LittleMooMooDingDingCow/3D-Printed-17-1-Cycloidal-Robotic-Actuator/Pictures&Videos/Screenshot 2026-03-27 005910.png

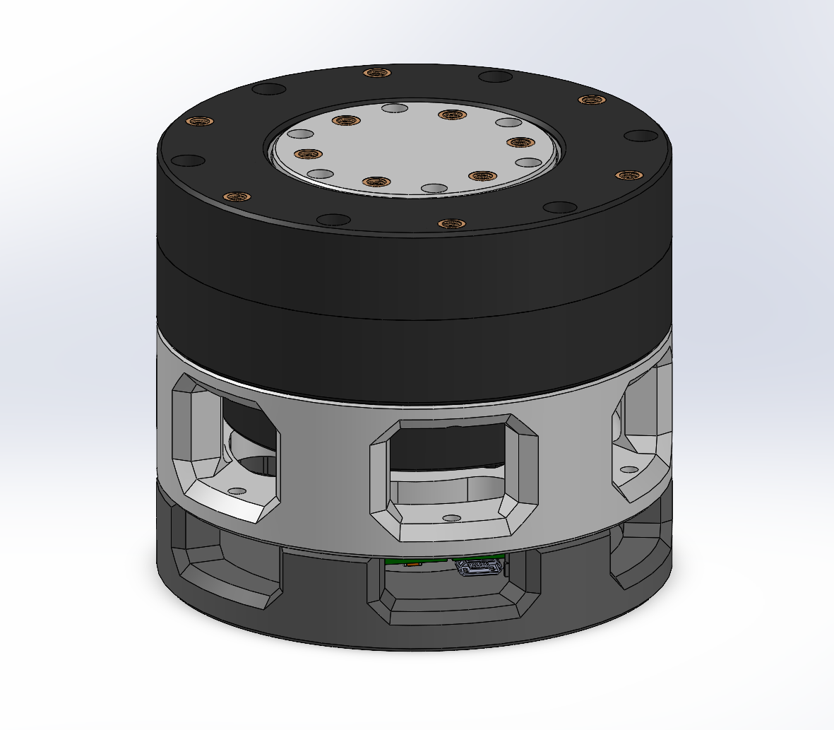
Pictures&Videos/Screenshot 2026-03-27 005910.png
