LittleMooMooDingDingCow/3D-Printed-17-1-Cycloidal-Robotic-Actuator/Cycloidal Actuator BOM/Cycloidal 25 to 1 BOM.xlsx

ITEM NO. | PART NUMBER | DESCRIPTION | Web Link for Purchasing | Cost per Time Purchased($) | Quantity Per Time Purchased (pcs & kg) | Part Unit Cost Per Purcahse($) | QTY. | Cost per Assembly
1 | Ring Gear | 3D printed PLA | https://a.co/d/0gjZemYR | 29.98 | 0.0301 | 0.451 | 1 | 0.451199
2 | Opposite Ring Gear |  |  |  | 0.0301 | 0.451 | 1 | 0.451199
3 | Cycloidal Gear |  |  |  | 0.0115 | 0.172 | 2 | 0.3444702
4 | Input Shaft |  |  |  | 0.0036 | 0.054 | 1 | 0.0535143
6 | Spacer Washer |  |  |  | 0.0002 | 0.002 | 1 | 0.0023984
11 | Bearing Spacer Big |  |  |  | 0.0004 | 0.006 | 1 | 0.0055463
13 | HM155kV Motor Mount V2 |  |  |  | 0.0422 | 0.633 | 1 | 0.6327279
14 | Encoder Magnent Mount |  |  |  | 0.0005 | 0.007 | 1 | 0.0068954
16 | Shaft Coupler for HM155KV |  |  |  | 0.0032 | 0.049 | 1 | 0.0485676
18 | FOC Board Spacer |  |  |  | 0.0001 | 0.002 | 4 | 0.0077948
23 | V3 Output Shaft Opposite |  |  |  | 0.0125 | 0.188 | 1 | 0.1876748
20 | V2 Output Shaft |  |  |  | 0.0195 | 0.293 | 1 | 0.2926048
7 | 50mm*65mm*7mm Ball Bearing | Bearing For both Ring Gears | https://a.co/d/0iJVO1oG | 28.09 | 10.0 | 2.809 | 2 | 5.618
8 | M3*0.5 BY 25mm Socket Head Screw | Screw to secure two Ring Gears together | https://www.aliexpress.us/item/2251832255868282.html | 2.65 | 50.0 | 0.053 | 6 | 0.318
9 | 15mm by 24mm by 5mm Ball Bearing | Beaing for Cycloidal Gear | https://www.aliexpress.us/item/3256805951929226.html | 7.78 | 10.0 | 0.778 | 2 | 1.556
10 | M3 by 8mm Button Head Cap Screw | Screw for both Motor Mount and Motor Coupler connection | https://www.aliexpress.us/item/3256807424674896.html | 3.29 | 50.0 | 0.066 | 10 | 0.658
12 | M4 by 8mm Button Head Cap Screw | Screw to secure the HM155kv onto Motor Mount | https://www.aliexpress.us/item/3256807424674896.html | 3.29 | 20.0 | 0.165 | 4 | 0.658
15 | M3 by 2.4mm Hex Nut | Nut to secure the FOC Board | https://www.aliexpress.us/item/3256807507915715.html | 1.71 | 50.0 | 0.034 | 4 | 0.1368
17 | HM-6208 motor | Electric Motor | https://www.hobbywingdirect.com/products/xrotor-m-6208-motor-ul | 60 | 1.0 | 60.000 | 1 | 60
19 | 22mm*10mm*6mm Ball Bearing | Bearing to secure the Input Shaft | https://a.co/d/02soELBD | 8.29 | 8.0 | 1.036 | 1 | 1.03625
21 | M2.5 by 25mm Socket Head Screw | Screw to secure and strengthen the Ouput Shaft | https://www.aliexpress.us/item/2251832255868282.html | 2.1 | 50.0 | 0.042 | 6 | 0.252
22 | 6mm*8mm*12mm Sleeve Bearing | Bearing to be used at the contact of Cycloidal Gear and the Output Shaft | https://a.co/d/09450dIv | 6.09 | 8.0 | 0.761 | 6 | 4.5675
24 | 25mm*37mm*7mm Bearing | Bearing to secure the Motor Coupler and the Input Shaft on the Output Shaft | https://a.co/d/0cG1vUeo | 13.19 | 10.0 | 1.319 | 1 | 1.319
25 | M3 by 5mm by 6mm Heat Insert | Heat Insert Nut for screw connection | https://a.co/d/02RLsYz4 | 9.19 | 100.0 | 0.092 | 30 | 2.757
26 | M2.5 by 4mm by 6mm Heat Insert | Heat Insert Nut for screw connection | https://a.co/d/0hLzXpKN | 7.29 | 100.0 | 0.073 | 6 | 0.4374
27 | Encoder Magnent | Used on Encoder Magnent Mount for Position Feedback | https://www.aliexpress.us/item/3256810015574251.html | 14.00 | 50.0 | 0.280 | 1 | 0.280
Total Cost Per Assembly($): |  |  |  |  |  |  |  | 81.93
