LittleMooMooDingDingCow/3D-Printed-17-1-Cycloidal-Robotic-Actuator/3D Printed Parts for Cycloidal Actuator/Actuator back cover.STL

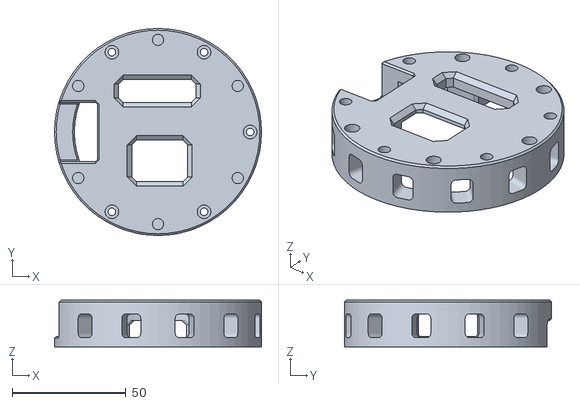
[picture p4: CAD file, 2026-03-31]
3D Printed Parts for Cycloidal Actuator/Actuator back cover.STL
91.0 x 91.0 x 20.5
