LittleMooMooDingDingCow/3D-Printed-17-1-Cycloidal-Robotic-Actuator/New 3D printed Parts for 25 to 1 Cycloidal Actuator/HM155kV MOTOR MOUNT V2.STL

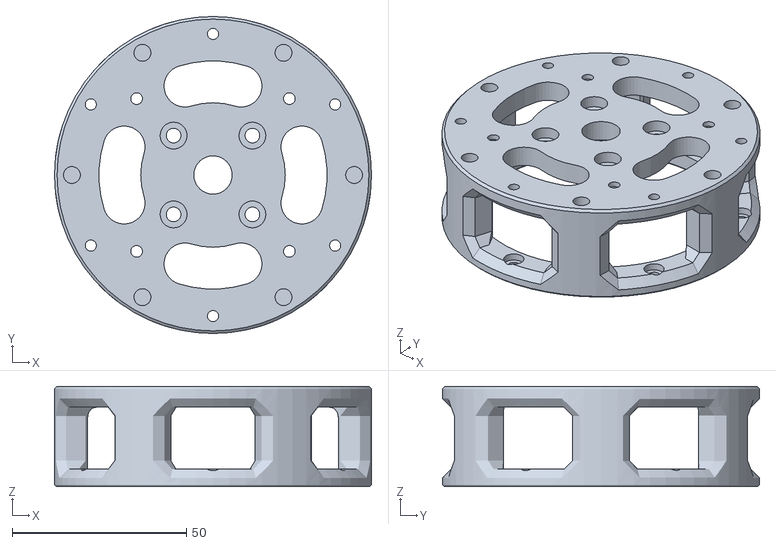
[picture p5: CAD file, 2026-09-04]
New 3D printed Parts for 25 to 1 Cycloidal Actuator/HM155kV MOTOR MOUNT V2.STL
91.0 x 91.0 x 28.8
