LittleMooMooDingDingCow/3D-Printed-17-1-Cycloidal-Robotic-Actuator/3D Printed Parts for Cycloidal Actuator/Actuator back cover for BG431 with cooling fan.STL

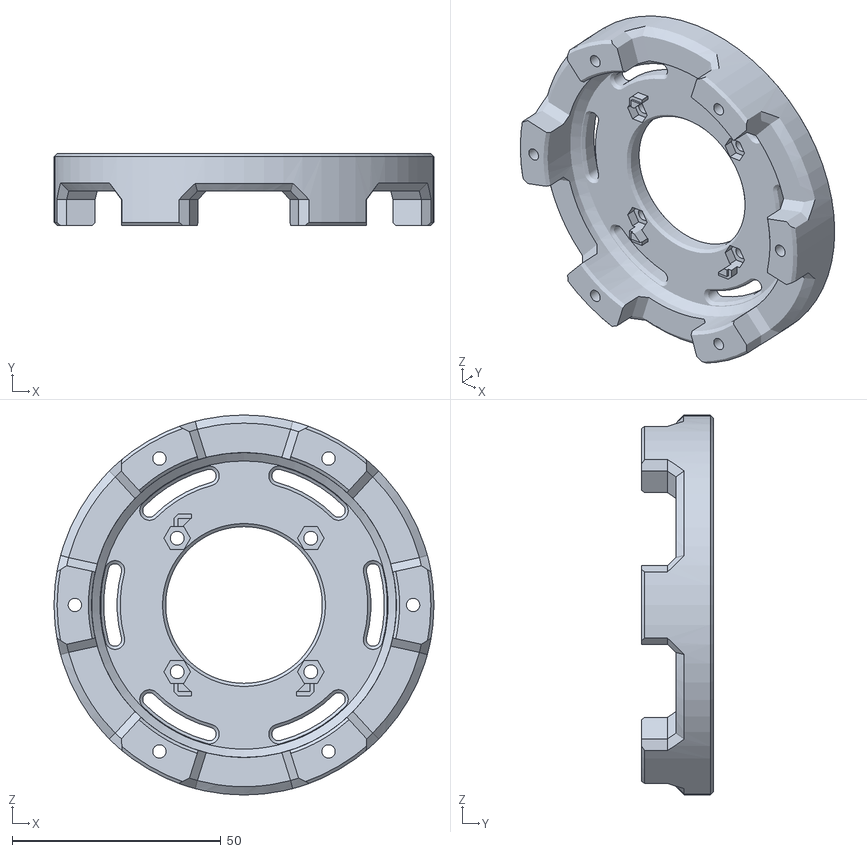
[picture p6: CAD file, 2026-03-31]
3D Printed Parts for Cycloidal Actuator/Actuator back cover for BG431 with cooling fan.STL
91.0 x 17.2 x 91.0
