LittleMooMooDingDingCow/3D-Printed-17-1-Cycloidal-Robotic-Actuator/New 3D printed Parts for 25 to 1 Cycloidal Actuator/V2 INPUT SHAFT.STL

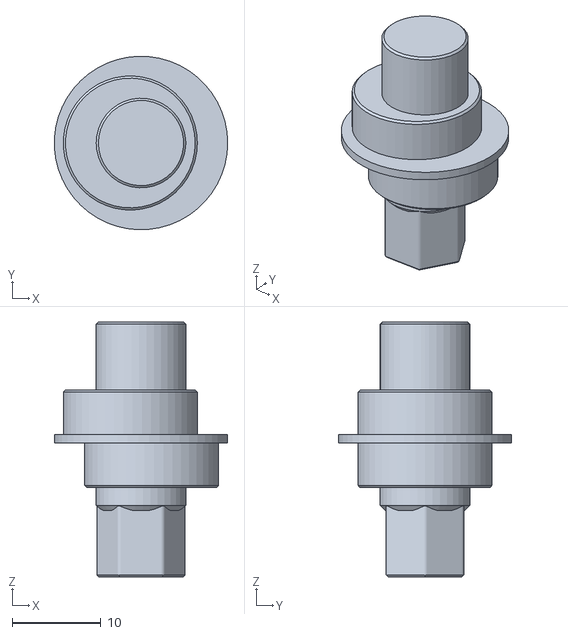
[picture p7: CAD file, 2026-09-04]
New 3D printed Parts for 25 to 1 Cycloidal Actuator/V2 INPUT SHAFT.STL
19.5 x 19.5 x 28.7
