LittleMooMooDingDingCow/3D-Printed-17-1-Cycloidal-Robotic-Actuator/3D Printed Parts for Cycloidal Actuator/AS5600 Encoder Mount.STL

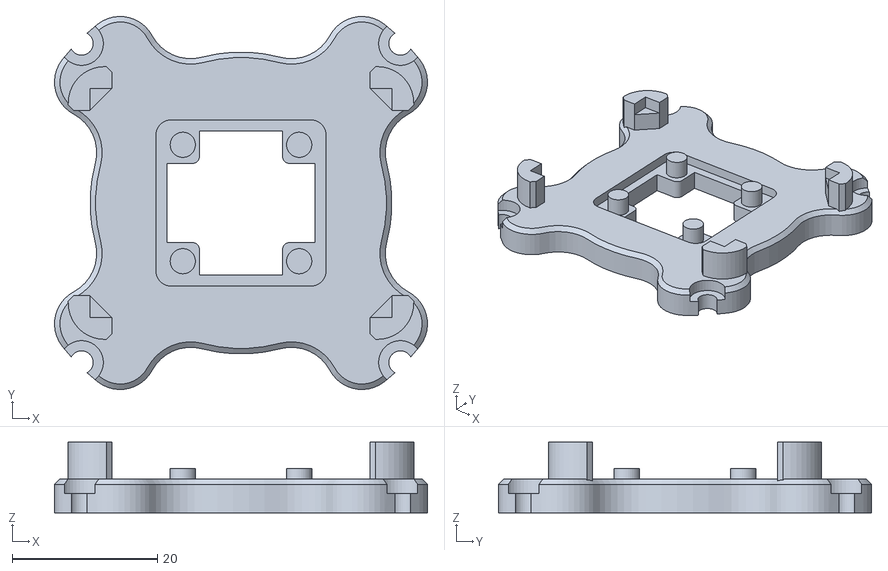
[picture p8: CAD file, 2026-03-31]
3D Printed Parts for Cycloidal Actuator/AS5600 Encoder Mount.STL
51.3 x 51.3 x 9.76
