LittleMooMooDingDingCow/3D-Printed-17-1-Cycloidal-Robotic-Actuator/New 3D printed Parts for 25 to 1 Cycloidal Actuator/V2 Cycloidal gear.STL

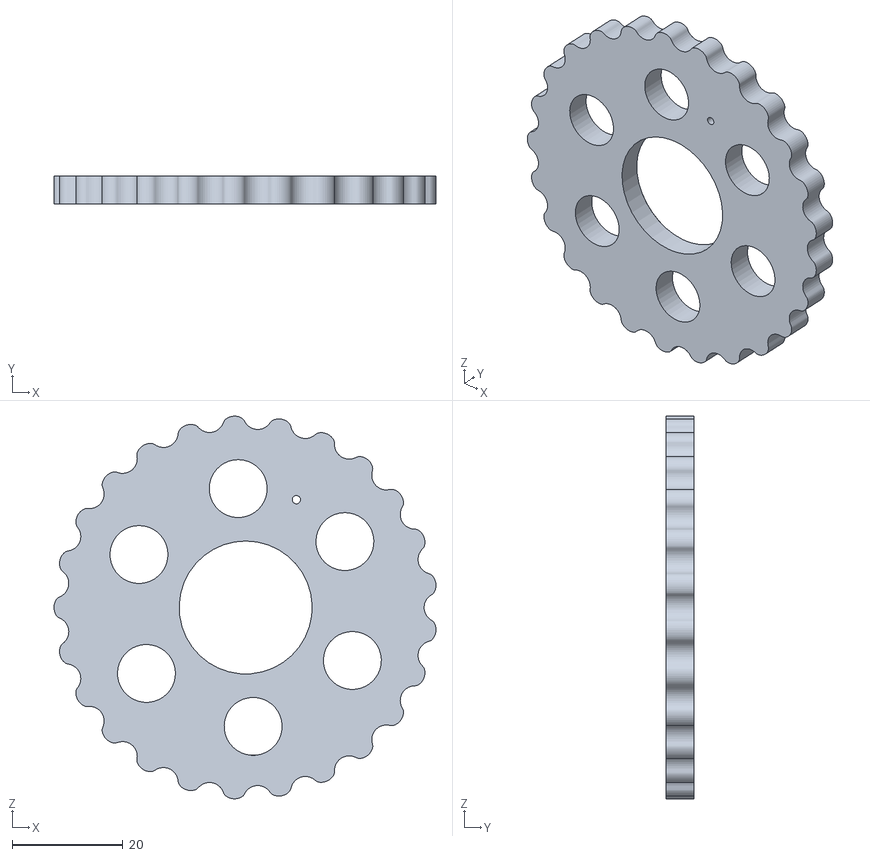
[picture p9: CAD file, 2026-09-04]
New 3D printed Parts for 25 to 1 Cycloidal Actuator/V2 Cycloidal gear.STL
68.9 x 5.00 x 69.1
