LittleMooMooDingDingCow/3D-Printed-17-1-Cycloidal-Robotic-Actuator/3D Printed Parts for Cycloidal Actuator/FOC board spacer.STL

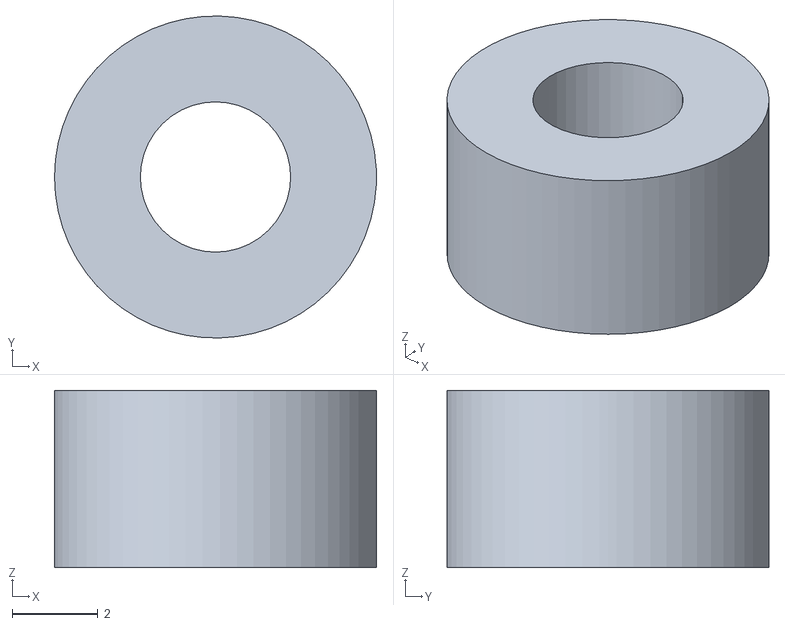
[picture p11: CAD file, 2026-03-31]
3D Printed Parts for Cycloidal Actuator/FOC board spacer.STL
7.50 x 7.50 x 4.13
