LittleMooMooDingDingCow/3D-Printed-17-1-Cycloidal-Robotic-Actuator/New 3D printed Parts for 25 to 1 Cycloidal Actuator/Encoder magnent mount.STL

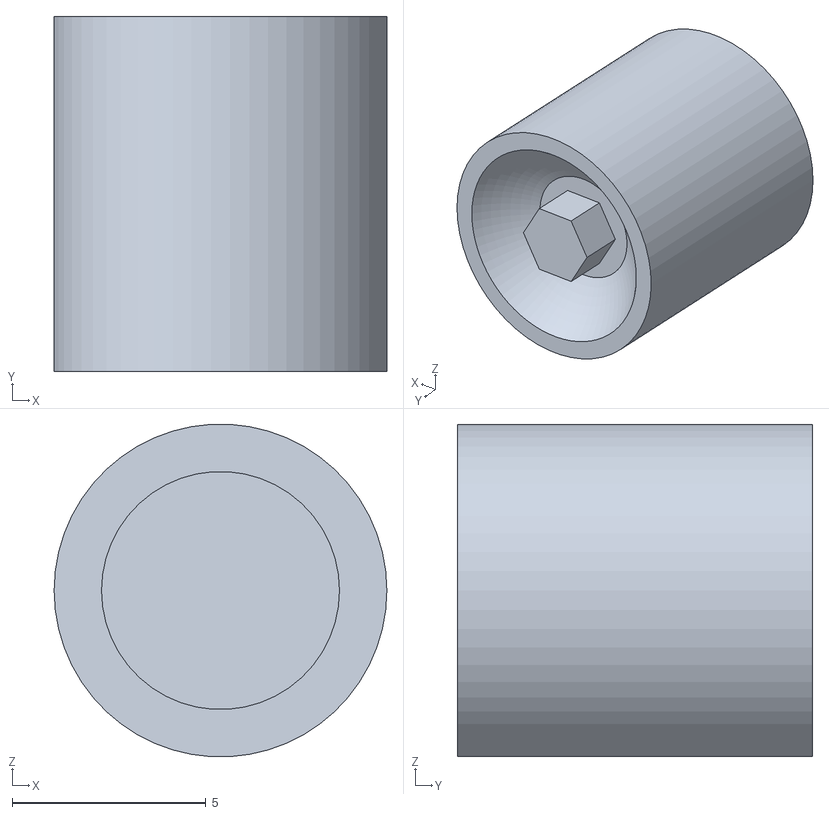
[picture p12: CAD file, 2026-09-04]
New 3D printed Parts for 25 to 1 Cycloidal Actuator/Encoder magnent mount.STL
8.60 x 9.17 x 8.59
