LittleMooMooDingDingCow/3D-Printed-17-1-Cycloidal-Robotic-Actuator/3D Printed Parts for Cycloidal Actuator/V3 opposite ring gear.STL

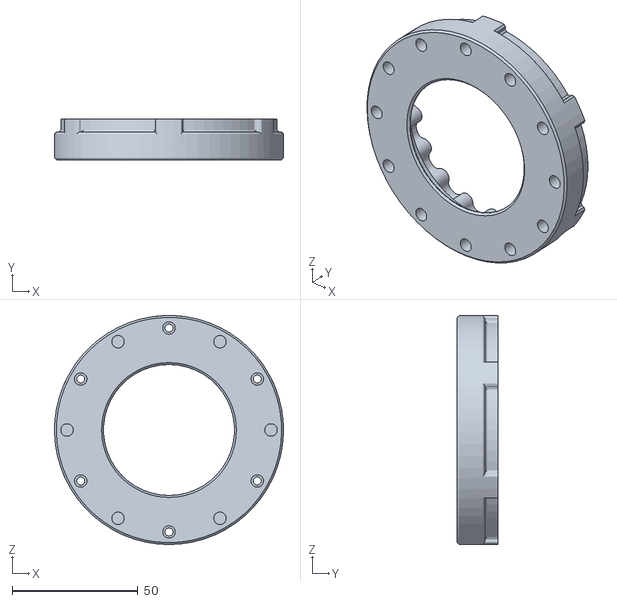
[picture p13: CAD file, 2026-03-31]
3D Printed Parts for Cycloidal Actuator/V3 opposite ring gear.STL
91.0 x 16.1 x 91.0
