LittleMooMooDingDingCow/3D-Printed-17-1-Cycloidal-Robotic-Actuator/New 3D printed Parts for 25 to 1 Cycloidal Actuator/Actuator back cover for BG431.STL

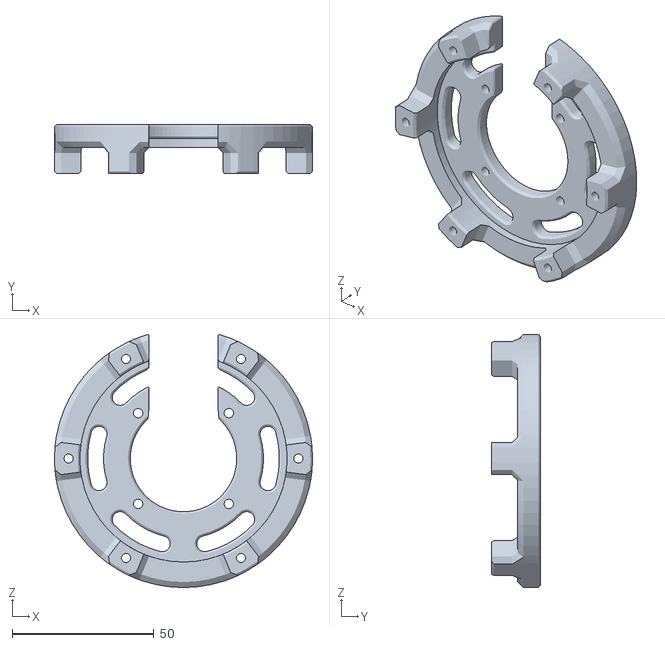
[picture p14: CAD file, 2026-09-04]
New 3D printed Parts for 25 to 1 Cycloidal Actuator/Actuator back cover for BG431.STL
91.0 x 17.2 x 89.3
