LittleMooMooDingDingCow/3D-Printed-17-1-Cycloidal-Robotic-Actuator/New 3D printed Parts for 25 to 1 Cycloidal Actuator/V2 OUTPUT SHAFT.STL

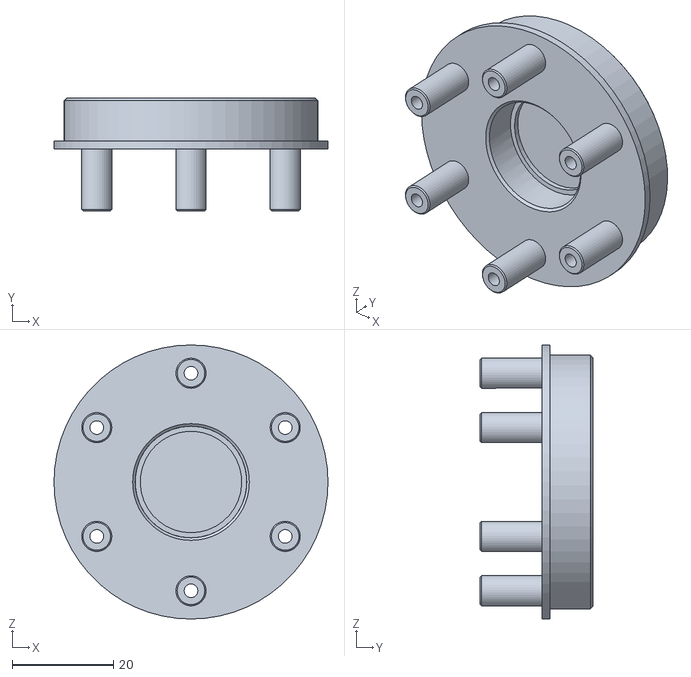
[picture p15: CAD file, 2026-09-04]
New 3D printed Parts for 25 to 1 Cycloidal Actuator/V2 OUTPUT SHAFT.STL
54.2 x 22.2 x 54.2
