LittleMooMooDingDingCow/3D-Printed-17-1-Cycloidal-Robotic-Actuator/3D Printed Parts for Cycloidal Actuator/V2 Cycloidal gear.STL

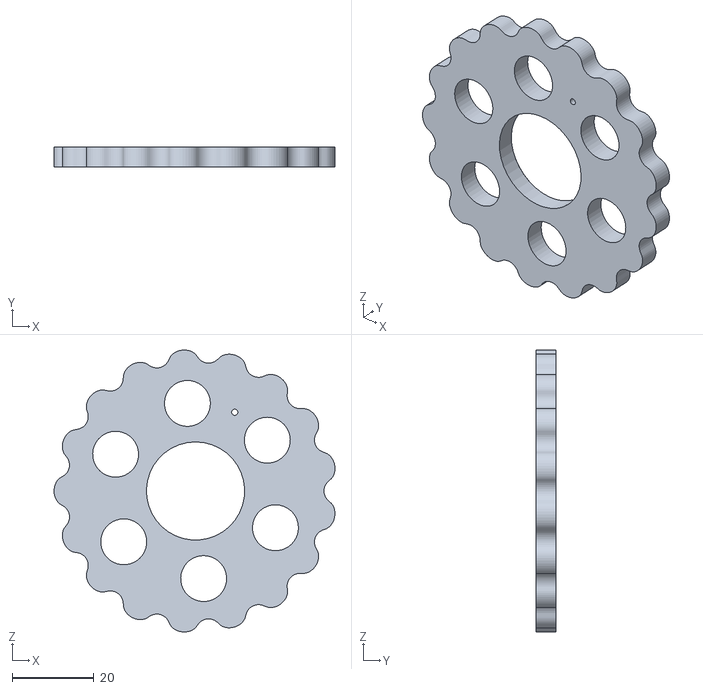
[picture p16: CAD file, 2026-03-27]
3D Printed Parts for Cycloidal Actuator/V2 Cycloidal gear.STL
68.7 x 5.00 x 68.9
