LittleMooMooDingDingCow/3D-Printed-17-1-Cycloidal-Robotic-Actuator/New 3D printed Parts for 25 to 1 Cycloidal Actuator/AS5600 Encoder Mount.STL

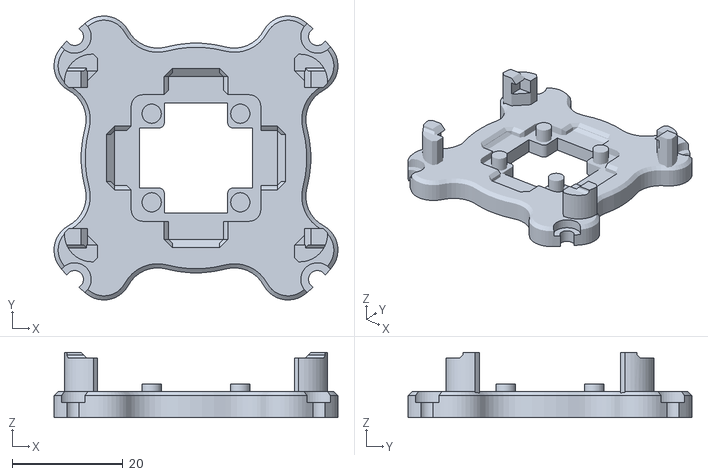
[picture p17: CAD file, 2026-09-04]
New 3D printed Parts for 25 to 1 Cycloidal Actuator/AS5600 Encoder Mount.STL
51.3 x 51.3 x 11.8
