LittleMooMooDingDingCow/3D-Printed-17-1-Cycloidal-Robotic-Actuator/3D Printed Parts for Cycloidal Actuator/V2 OUTPUT SHAFT.STL

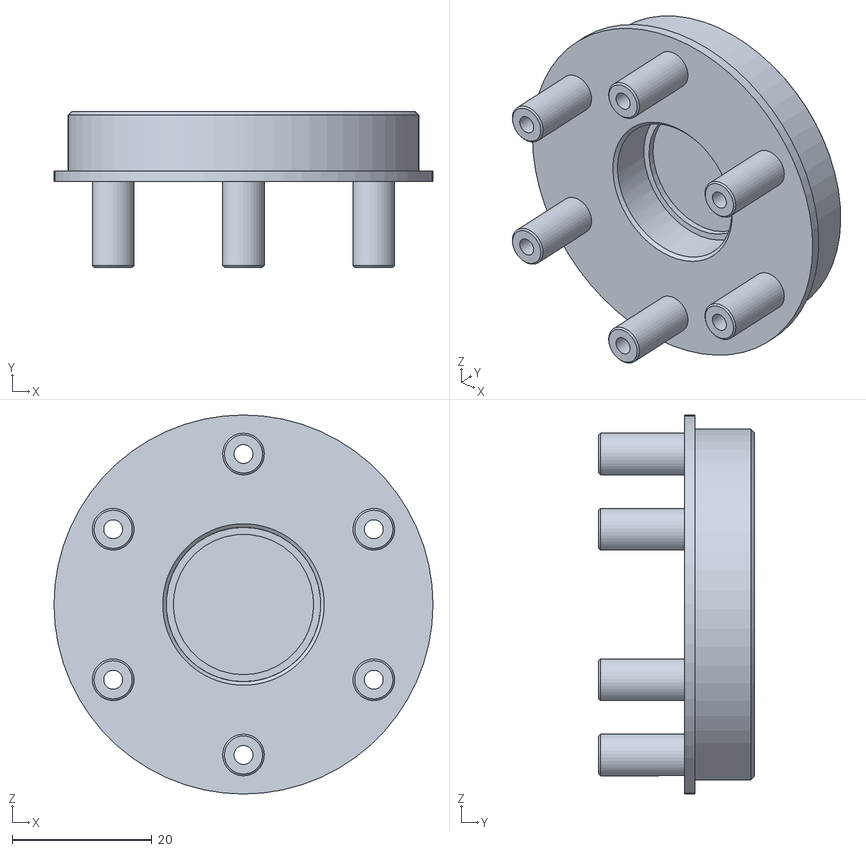
[picture p18: CAD file, 2026-03-27]
3D Printed Parts for Cycloidal Actuator/V2 OUTPUT SHAFT.STL
54.2 x 22.2 x 54.2
