LittleMooMooDingDingCow/3D-Printed-17-1-Cycloidal-Robotic-Actuator/New 3D printed Parts for 25 to 1 Cycloidal Actuator/V3 Output shaft opp.STL

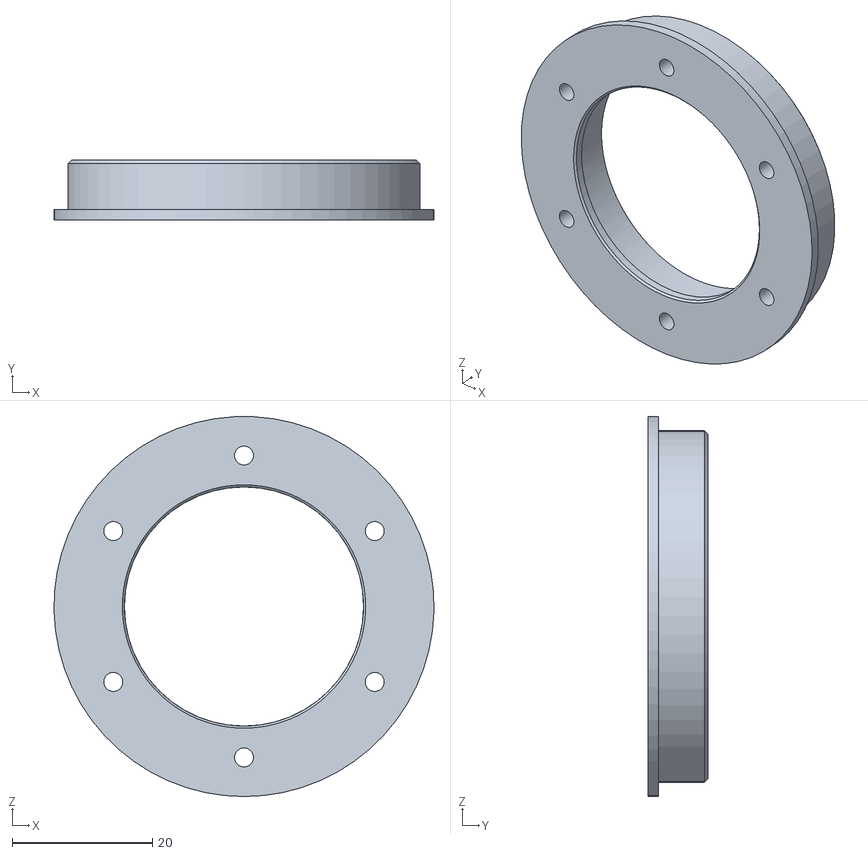
[picture p19: CAD file, 2026-03-27]
New 3D printed Parts for 25 to 1 Cycloidal Actuator/V3 Output shaft opp.STL
54.1 x 8.50 x 54.2
