LittleMooMooDingDingCow/3D-Printed-17-1-Cycloidal-Robotic-Actuator/3D Printed Parts for Cycloidal Actuator/Bearing spacer Big.STL

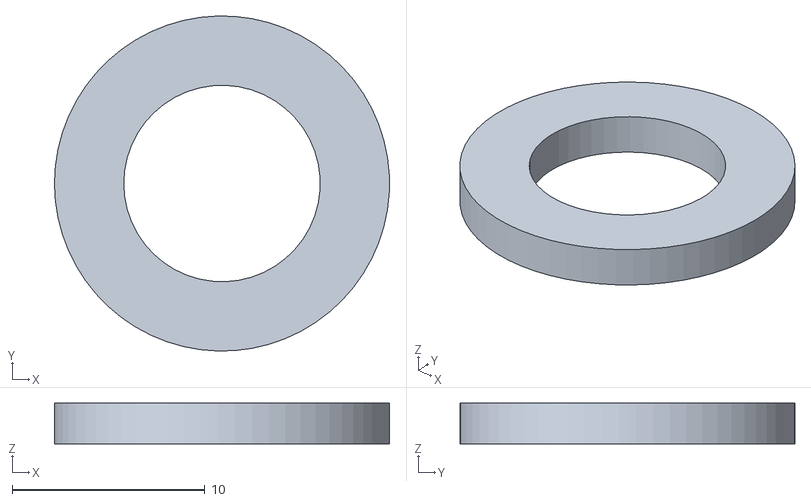
[picture p20: CAD file, 2026-03-27]
3D Printed Parts for Cycloidal Actuator/Bearing spacer Big.STL
17.4 x 17.4 x 2.12
