LittleMooMooDingDingCow/3D-Printed-17-1-Cycloidal-Robotic-Actuator/New 3D printed Parts for 25 to 1 Cycloidal Actuator/Shaft coupler for EA60.STL

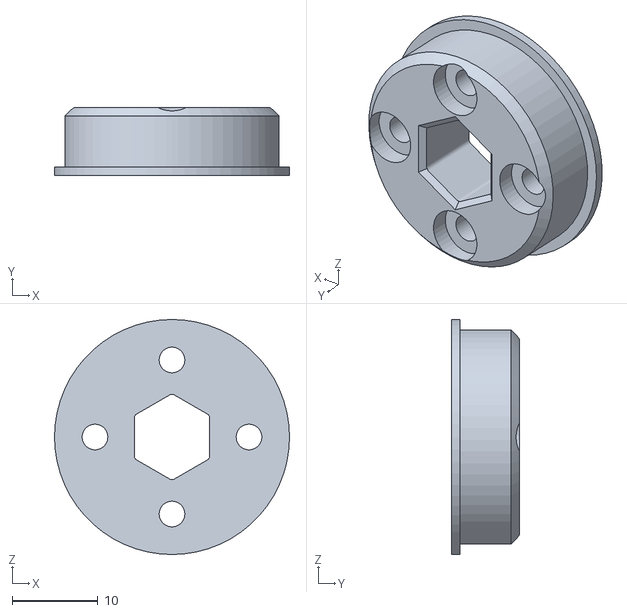
[picture p21: CAD file, 2026-03-27]
New 3D printed Parts for 25 to 1 Cycloidal Actuator/Shaft coupler for EA60.STL
27.5 x 8.00 x 27.5
