LittleMooMooDingDingCow/3D-Printed-17-1-Cycloidal-Robotic-Actuator/3D Printed Parts for Cycloidal Actuator/Encoder magnent mount.STL

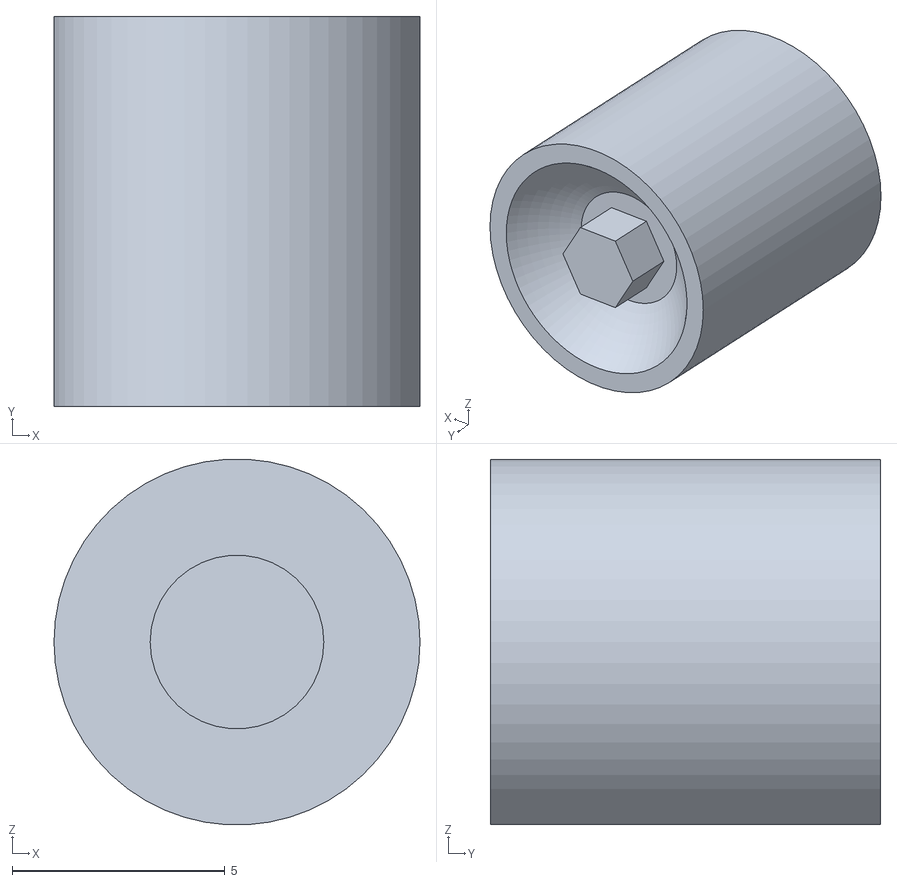
[picture p22: CAD file, 2026-03-27]
3D Printed Parts for Cycloidal Actuator/Encoder magnent mount.STL
8.60 x 9.17 x 8.59
