LittleMooMooDingDingCow/3D-Printed-17-1-Cycloidal-Robotic-Actuator/(list of files, cad)

Other CAD files:
New 3D printed Parts for 25 to 1 Cycloidal Actuator/V3 ring gear.STL
3D Printed Parts for Cycloidal Actuator/HM155kV MOTOR MOUNT V2.STL
New 3D printed Parts for 25 to 1 Cycloidal Actuator/V3 opposite ring gear.STL
3D Printed Parts for Cycloidal Actuator/Actuator back cover for BG431.STL
3D Printed Parts for Cycloidal Actuator/V2 INPUT SHAFT.STL
3D Printed Parts for Cycloidal Actuator/SPACER WASHER.STL
3D Printed Parts for old 17 to 1 Cycloidal Actuator/Actuator back cover for BG431.STL
3D Printed Parts for old 17 to 1 Cycloidal Actuator/HM155kV MOTOR MOUNT V2.STL
3D Printed Parts for old 17 to 1 Cycloidal Actuator/SPACER WASHER.STL
3D Printed Parts for old 17 to 1 Cycloidal Actuator/V2 INPUT SHAFT.STL
