LittleMooMooDingDingCow/3D-Printed-17-1-Cycloidal-Robotic-Actuator/(commit log)

2026-03-27 stl files for printing
    cycloidal actuator stl files for printing
    [AS5600 Encoder Mount.STL, Actuator back cover for BG431.STL, Bearing spacer Big.STL, Encoder magnent mount.STL, HM155kV MOTOR MOUNT V2.STL, SPACER WASHER.STL, Shaft coupler for EA60.STL, V2 Cycloidal gear.STL]
2026-03-27 Wrong file
    [Actuator back cover for BG431.STL, V3 opposite ring gear.STL, V3 ring gear.STL]
2026-03-27 stl files for printing
    [Actuator back cover for BG431.STL, V3 opposite ring gear.STL, V3 ring gear.STL]
2026-03-27 file change
    [AS5600 Encoder Mount.STL, Bearing spacer Big.STL, Encoder magnent mount.STL, HM155kV MOTOR MOUNT V2.STL, SPACER WASHER.STL, Shaft coupler for EA60.STL, V2 Cycloidal gear.STL, V2 INPUT SHAFT.STL]
2026-03-27 file location change
    [Actuator back cover for BG431.STL, V3 opposite ring gear.STL, V3 ring gear.STL]
2026-03-27 Create BOM of V5 cycloidal actuator without board cover Final.xlsx
    [BOM of V5 cycloidal actuator without board cover Final.xlsx]
2026-03-27 Update HM155kV MOTOR MOUNT V2.STL
    [HM155kV MOTOR MOUNT V2.STL]
2026-03-31 FOC driver cover with cooling fan mount upgrade and new ring gear with lighter weight
    [AS5600 Encoder Mount.STL, Actuator back cover for BG431 with cooling fan.STL, Actuator back cover.STL, FOC board spacer.STL, V3 opposite ring gear.STL, V3 ring gear.STL]
2026-09-04 new 25 to 1 added
    [17 to 1 cycloidal actuator without board cover BOM.xlsx, AS5600 Encoder Mount.STL, Actuator back cover for BG431 with cooling fan.STL, Actuator back cover for BG431.STL, Actuator back cover.STL, Bearing spacer Big.STL, Cycloidal 25 to 1 BOM.xlsx, Encoder magnent mount.STL]
2026-09-04 Update README with 25:1 actuator details and recommendations
    Added information about the 25:1 gear ratio actuator and recommendations for use. Included links for further guidance on motor controller implementation and firmware usage.
